Dovgalyuk/ApogeyROMDisk/49F040/photo1.jpg

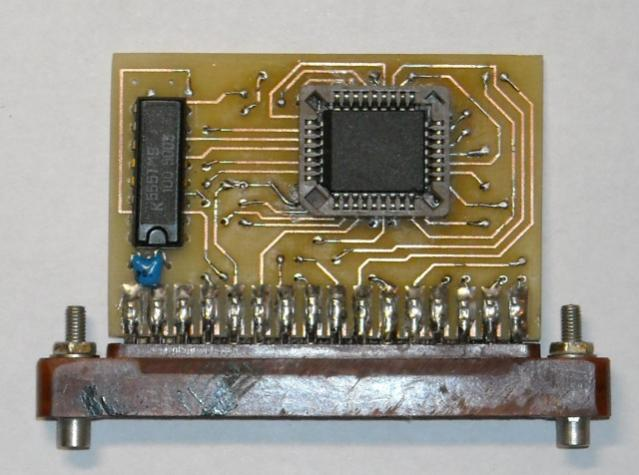
49F040/photo1.jpg
