Dovgalyuk/ApogeyROMDisk/49F040/Plata_Int/3d.JPG

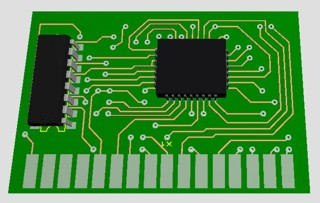
49F040/Plata_Int/3d.JPG
