Dovgalyuk/ApogeyROMDisk/MyDisk/README.md

Разводка платы под микросхему AT49F040.

Файл с исходниками разводки для FreePCB.

Файлы для загрузки на фабрику ITEAD Studio.
