Dovgalyuk/ApogeyROMDisk/49F040/photo2.jpg

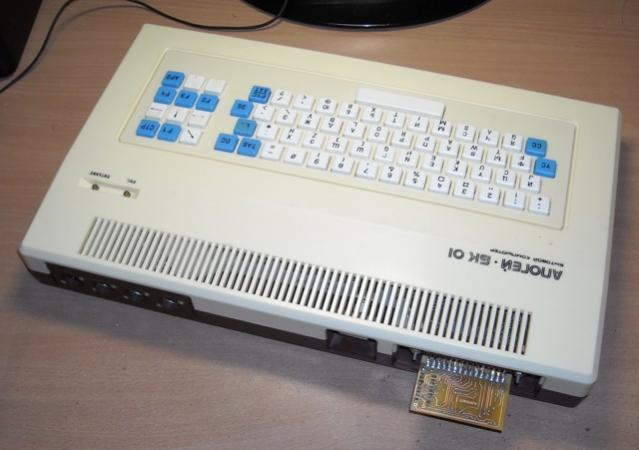
49F040/photo2.jpg
