Dovgalyuk/ApogeyROMDisk/49F040/Plata_DIP/3d.jpg

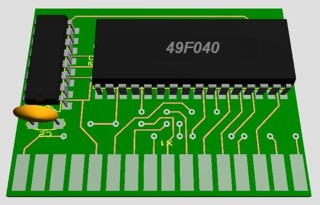
49F040/Plata_DIP/3d.jpg
