Dovgalyuk/ApogeyROMDisk/49F040/Plata_DIP/apogey_cart.PNG

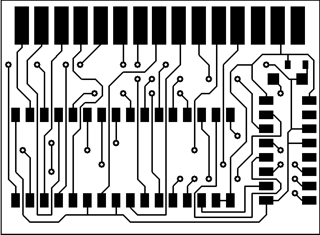
49F040/Plata_DIP/apogey_cart.PNG
