Dovgalyuk/ApogeyROMDisk/49F040/Plata_Ext/3d.JPG

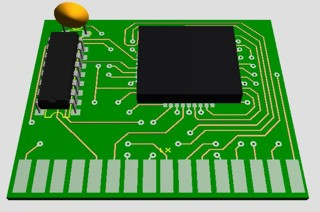
49F040/Plata_Ext/3d.JPG
