Dovgalyuk/ApogeyROMDisk/49F040/shema.png

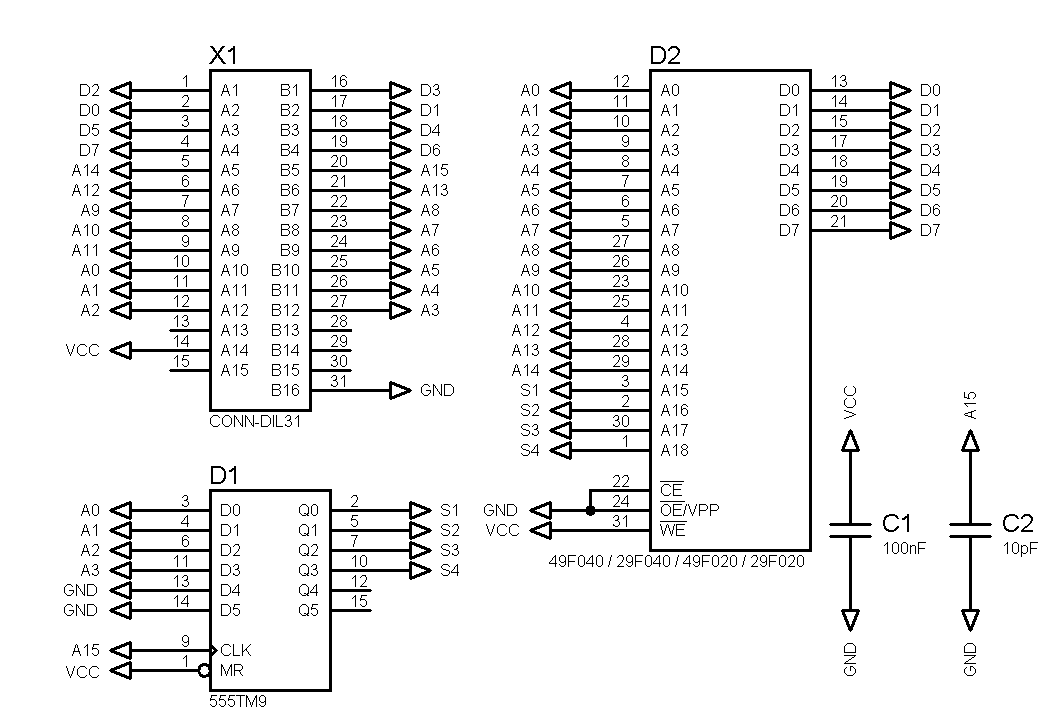
49F040/shema.png
