Dovgalyuk/ApogeyROMDisk/49LF004/Board/DSCN5123.JPG

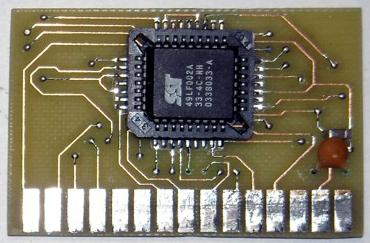
49LF004/Board/DSCN5123.JPG
