Dovgalyuk/ApogeyROMDisk/49LF004/Board/DSCN5136.JPG

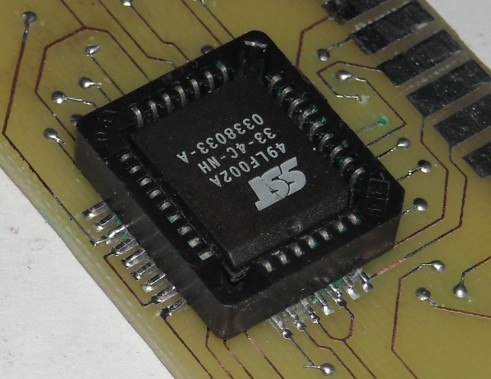
49LF004/Board/DSCN5136.JPG
