Dovgalyuk/ApogeyROMDisk/(list of files, drawings)

Other design files:
49F040/Plata_DIP/apogey_cart.DSN
49F040/Plata_DIP/apogey_cart.LYT
49F040/Plata_Ext/apogey_cart.DSN
49F040/Plata_Ext/apogey_cart.LYT
49F040/Plata_Int/apogey_cart.DSN
49F040/Plata_Int/apogey_cart.LYT
49LF004/Board/Proteus/ApogeyRomDisk_LF2.DSN
49LF004/Board/Proteus/ApogeyRomDisk_LF2.LYT
