Dovgalyuk/ApogeyROMDisk/(commit log)

2016-11-15 Added downloaded files
    [ApogeyRomDisk_LF2.DSN, ApogeyRomDisk_LF2.LYT, ApogeyRomDisk_LF2.SDF, apogey_cart.DSN, apogey_cart.LYT, apogey_cart.SDF]
2016-11-15 Added PCB
    [rom.gbl, rom.gbo, rom.gbs, rom.gko, rom.gtl, rom.gto, rom.gts]
